ooISHoo/Arduino_YM2151/SketchMDXPlayer/Readme.txt

This software is released under the MIT License, see Licence.txt.
