ooISHoo/Arduino_YM2151/EAGLEproject/MTM05_R1d2.PNG

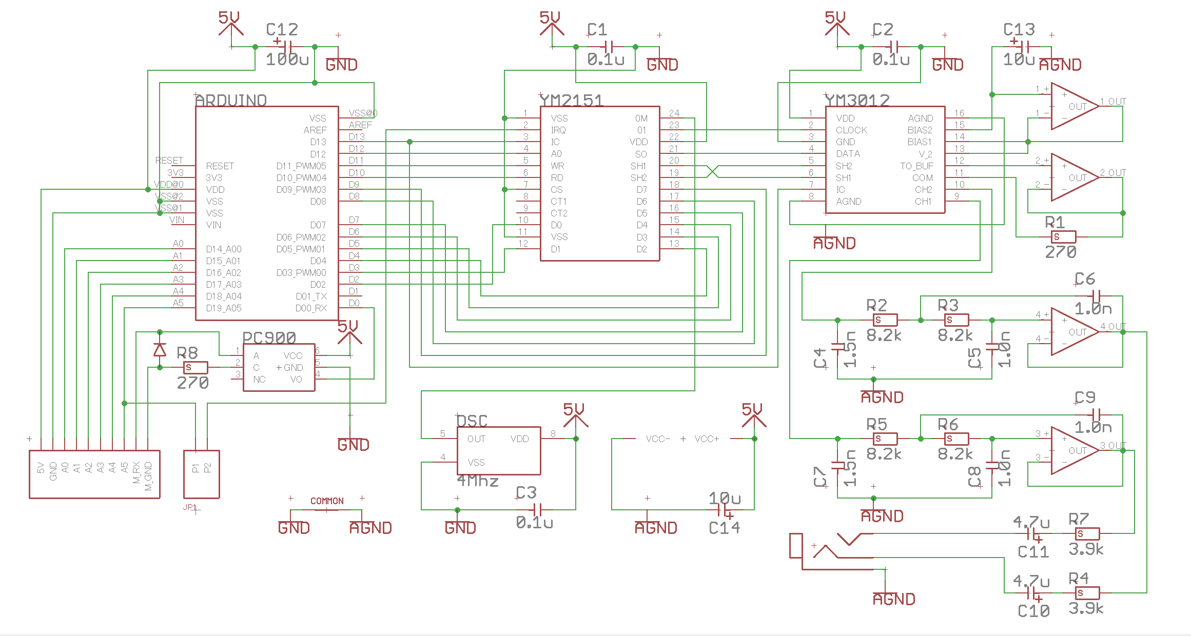
EAGLEproject/MTM05_R1d2.PNG
