ooISHoo/Arduino_YM2151/YM2151ShieldKitManual_EN-0.1.pdf

YM2151Shield Assembly Manual

## このキットについて

このキットはマイコンボード「ArduinoDuemilanove」へシールドとして接続することにより、ヤマ ハ製 FM 音源 IC である YM2151 を I/O 直結で操作することを目的としています。 出力はステレオラ インなのでお手持ちのアンプなどに接続してお楽しみ下さい。各ソフトウェアのダウンロードは、下 記 URL にてお願いします。

## http://www.ooishoo.org/ym2151shield

## !!注意、ハードを破損する可能性あり!!

1) 組み立てたシールドは Arduino と接続する前に、必ず HP より MDX プレイヤースケッチ、もし くは YM2151 操作ライブラリのサンプルスケッチをダウンロードして Arduino へ書き込んでくださ い。 Arduino のデジタル IO 操作により擬似的に双方向バスの動作を再現している為、正しく IO 操 作を行わないと出力が衝突し故障の原因となります。
2) MDX ファイルイメージ転送ツールは Duemilanove のブートローダ向けに記述してある為、これ 以外の Arduino 互換機や後継機で実行するとブートローダを破損する危険があります。HP 上で公式 に対応をアナウンスされていない場合は絶対に実行しないでください。破損してしまった場合は Arduino を扱っているショップ(スイッチサイエンス様等)でブートローダ書き込み済みの ATMega を 購入するか、純正 ISP で再度書き込み可能です。

Circuit Diagram (http://ja.bab.la/%E8%BE%9E%E6%9B%B8/%E8%8B%B1%E8%AA%9E-%E6%97%A5%E6%9C%AC%E8%AA%9E/circuit-diagram)

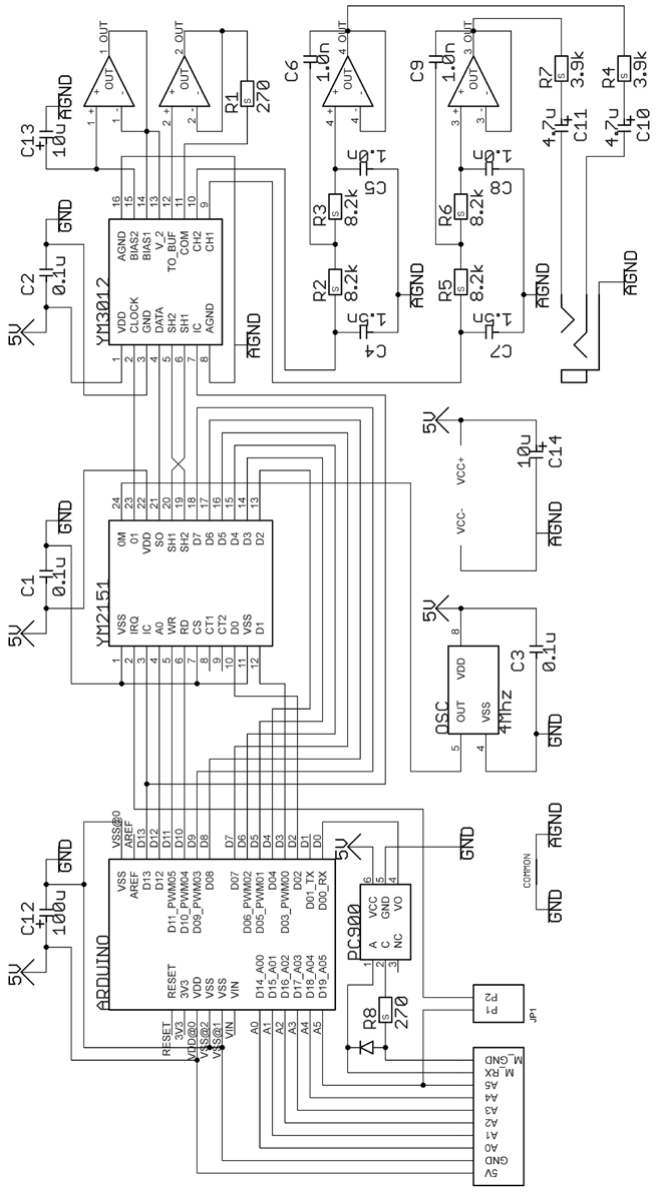
[picture p2: figure]

## Parts Arrangement

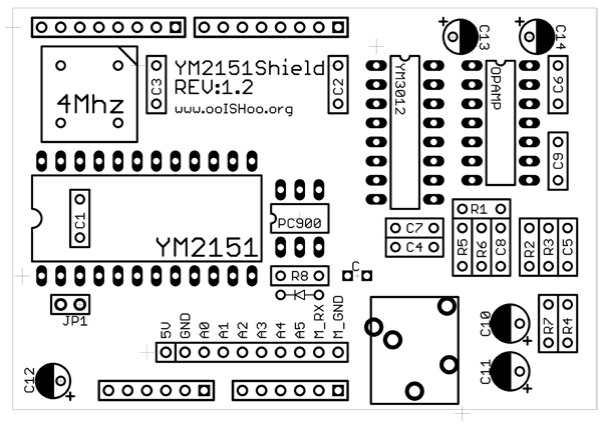
[picture p3: figure]

## Parts List

Name | Symbol | X | Comment | Image
Resisters 8.2KΩ | R2,R3 R5,R6 | 4 | Grey,Red,Red,Gold
Resisters 3.9KΩ | R4,R7 | 2 | Orenge,White,Red,Gold
Resisters 270Ω | R1,R8 | 2 | Red,Violet,Brown,Gold
Al-Electrolyte type capacitor 100uF10V | C12 | 1 | White line on the side of the capacitor can indicate its negative lead.
Solid electrolyte type capacitors 10uF10V | C13,C14 | 2 | White line on the side of the capacitor can indicate its negative lead.

Bi-polarized type capacitors 4.7uF50V | C10,C11 | 2
Monolithic ceramic chip capacitors 0.1uF | C1,C2 C3 | 3 | C1 is tilting mount, so put under the IC socket.
Film capacitors 1.5nF | C4,C7 | 2 | Attention! There are the same shape parts. Printed ‘1n5’.
Film capacitors 1.0nF | C5,C6 C8,C9 | 4 | Attention! There are the same shape parts. Printed ‘1n0’.
FM-Synth YM2151 | - 1
DAC YM3012 | - | 1 | Small dot mark is pin number 1.
Quad OP amps TLC2274 | - 1
Photo coupler PC900V | - | 1 | Small dot mark is pin number 1.
Oscillator 4MHz | - | 1 | Attention! Mounted to the opposite direction on PCB. Match the printed dot mark.
Diode 1N4148 | - | 1 | Black line on the side of the diode can indicate its cathode lead.
(Cathode) | (Anode)

3.5mm stereo mini jack | - | 1 | Attention! Easy distortion on soldering heat.
24P-IC socket | - | 1 | For YM2151
16P-IC socket | - | 1 | For YM3012
10P Pin socket | - | 1 | Mounted on PCB
40P Pin header | - | 1 | Fold to insert Arduino into first.

## Assembly Example Photo

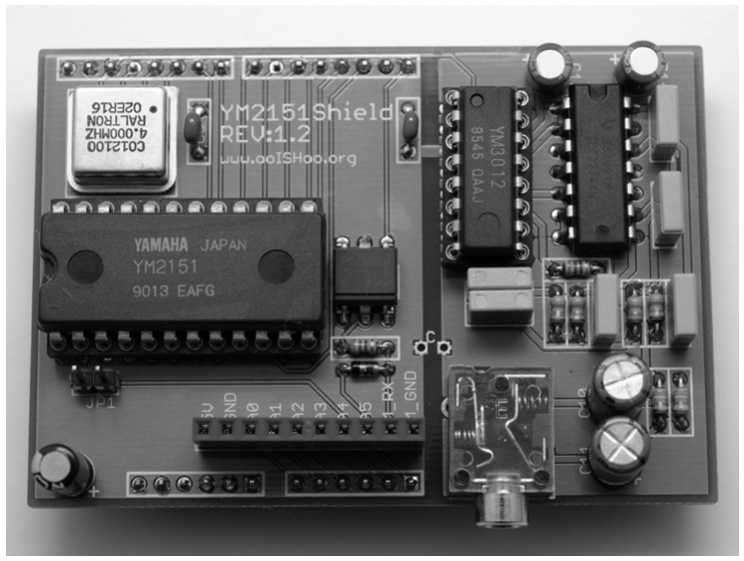
[picture p4: figure]

## 必要な工具

- 一般部品用ハンダごて
- ハンダ(基板は有鉛レベラ仕様となっておりますので、無鉛ハンダである必要はありません)
- ニッパ
- ペンチ
- テスター(あると便利)
- 逆作用ピンセット(部品仮固定用、あると便利)
- 紙テープ(部品仮固定用、あると便利)

## 組立手順

- 抵抗、直付け IC、IC ソケット等、背の低い物から順にハンダ固定していきます。
- IC は全て新品ですので、足を予め内側に押し曲げてから挿入してください。
- 部品穴は全てスルーホールとなっておりますので、下面のみハンダで十分です。
- 抵抗が 1/6W な為、カラーコードが読みにくいので取り違えにご注意ください。
- オシレータのみ実装向きが逆です、ご注意ください。
- フィルムコンデンサは 2 種類ありますので取り違えにご注意ください。
- フィルムコンデンサに nF という見慣れない単位を使用していますが 1nF=1000pF となっており ます。
- 10P ヘッダおよび 3.5mm ミニピンジャックはハンダ付け中に浮いてしまいがちですので、しっ かり固定してください。
- ピンヘッダは、Arduino に挿入した状態でハンダ付けして下さい。曲がった状態でハンダ付けし てしまうと Arduino との接続が困難になります。
- 基板中央に「C」とシルクがあるランドがありますが、EDA ツールの仕様による未使用ランドな ので無視して下さい。
- 抵抗は 1 本ずつ余分に同梱したつもりなので余ります。

## 動作テスト前の確認事項、必ずチェック!

- Arduino の ISP ヘッダとシールド基板間のクリアランスがあまり無いので、干渉していないかチ ェック。
- GND と+5V の抵抗を測り短絡していないかチェック。
- Arduino 側に YM2151 シールド用のスケッチが予め書き込まれているかチェック。

## MDXImageTransfer 使用説明

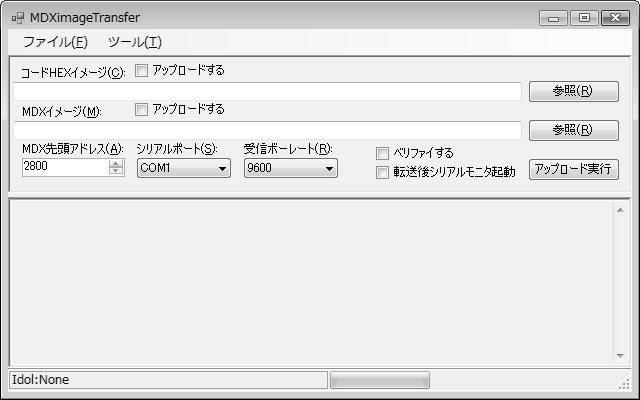
[picture p5: figure]

MDXImageTransferは MDX 再生スケッチ用に書かれた、Arduino のプログラムフラッシュ領域に USB シリアル経由でファイルイメージを転送することを目的としたツールです。WindowsXP/Vista/7 で動 作しますが、実行には.NET FrameWork のランタイムライブラリが必要です。

Duemilanove ブートローダの個人的な解析に基づいて記述していますので、互換性は保証できませ んのでご注意ください。

MDX 再生用スケッチの書き込み

先立って Arduino 上に MDX 再生スケッチをロードする必要があります。HP からプログラムダウン ロード後、ArduinoIDE でコンパイル&転送を行います。COM ポートを空ける為、転送後 ArduinoIDE を終了します。

MDX イメージの転送

まずコントロールパネル等で Arduino がどの COM ポートにアサインされているかチェックしてくだ さい。プログラム起動後、中程に「シリアルポート」とあるドロップダウンがありますので、アサイ ンされているポートを指定してください。プログラム起動後 Arduino を接続した場合はメニューの 「ツール→シリアルポート再検索」で更新されます。

次に中段の MDX イメージの横にある「参照」ボタンで MDX ファイルを指定してください。その後 「アップロード」ボタンを押すと、自動でリセット、転送、再起動されます。MDX 先頭アドレスは 再生用スケッチとアドレスを合致させる必要があります。サンプルそのままでしたら特に変更の必要 はありません。また ATMega のプログラムフラッシュを MDX 再生スケッチ、MDX ファイルイメー ジ、Arduino ブートローダで共用していますので、ファイルイメージの最大サイズには制限がありま す。サイズチェックはロード時に行っていますのでプログラムを破損することはありません。

COM ポートは排他利用となっていますので、COM ポート占有する ArduinoIDE との同時起動はでき ません。

おまけ機能について

プログラムの hex ファイル転送やシリアルモニタ、自動連続転送機能等もデバッグやデモ目的で実装 されていますが、特にこれらを組み合わせた場合の動作確認が不十分なので、原則的にはご使用なさ らないようお願いします。Arduino はブートローダエリアに書かれているプログラムにより IDE 他と シリアル通信し、セルフプログラミングを行う仕様になっておりますので、ブートローダを破損して しまうと機能しなくなります。

## MIDI 入力機能(コネクタ別売り)

このシールドには MIDI 入力が用意されています。コネクタは付属していませんので、まず秋葉原等 の電子部品小売店で販売されている「DIN 5 ピンメスコネクタ」を用意します、写真のように手ハン ダタイプが使い易いかと思います。これにブレッドボード用ジャンパワイア等をカットしてピンヘッ ダメスに差し込めるように信号を引き出します。

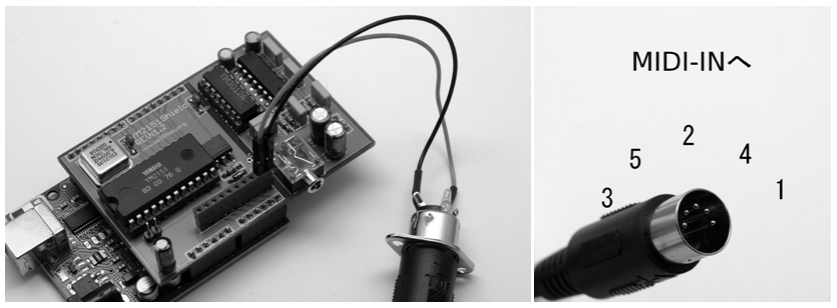
[picture p6: figure]

一般的な MIDI クロスケーブルで接続する場合、ピンアサインはオスコネクタで見て上右の写真のよ うになっています、使われているのはこの内 4 番ピン(IN+)5 番ピン(IN-)のみなので、4 番(IN+)をシー ルド上の 10 ピンヘッダシルク M_RX へ、5 番(IN-)を M_GND へ接続します。シリアル信号はフォト カプラ経由なので負論理になります。

MIDI 入力機能に関する注意

Arduino の FTDI と RX を共用していますので、プログラム転送中に MIDI 信号が入らないよう注意が 必要です。転送データに MIDI 信号が重なり、最悪ブートローダを破損してしまいます。

## YM2151 の割り込み信号の使用について

Arduino が高精度タイマを持っているので、アナログ入力を空けるために YM2151 の割込み出力は未 接続になっておりますが、JP1 をショートすることにより Analog04 に入力することが可能です。付 属ピンヘッダを取り付けてください。ジャンパピンは付属しておりませんので 2.54mm ピッチの汎用 品をご用意願いします。

## ライン出力のレベルについて

当シールドのライン出力は簡素化の結果、やや低めのレベルとなっております(1.4～1.3Vp-p 程度)気 になる方はシンプルな回路ですので改造に挑戦してみてください。

## サポートとお願い

キットの部品内容に不足がある、基板に不具合がある、ハードが動作しない、ソフトにバグがある、 等不具合やご質問等は、

ym2151shield@ooISHoo.org

までメールをお願いします。但し個人ベースで運用しておりますので、レスポンスやサポート内容に 至らない点が多々あるかと思いますので何卒ご容赦願います。

最後にお願いになりますが、今回製造中止になった古いチップで遊ぶという試みで無用に貴重な流通 在庫を消費してしまったので、不要になりましたチップは破棄せずオークション等で必要な方に渡る よう配慮をお願いします。
