ooISHoo/Arduino_YM2151/(threads)

Thread 2 (2019-09-22):

Schematics won't open in kicad 5.1.4

Lucretia, 2019-09-22:

ooISHoo, 2020-04-06:
Added the missing library to the EAGLE project file. Library import operation is required.

Closed 2020-04-06.
