ooISHoo/Arduino_YM2151/(commit log)

2018-07-29 Fix for VS2017 and ArduinoIDE 1.6
    [Common.h, IO.cpp, IO.h, MDXParser.cpp, MDXParser.h, MMLParser.cpp, MMLParser.h, SketchMDXPlayer.pde]
2020-04-06 Added the missing library to the EAGLE project file.
    [YM2151ShieldR3.brd, YM2151ShieldR3.sch]
